GlenSearle/Pogo-pin-clamp/pogo.stl

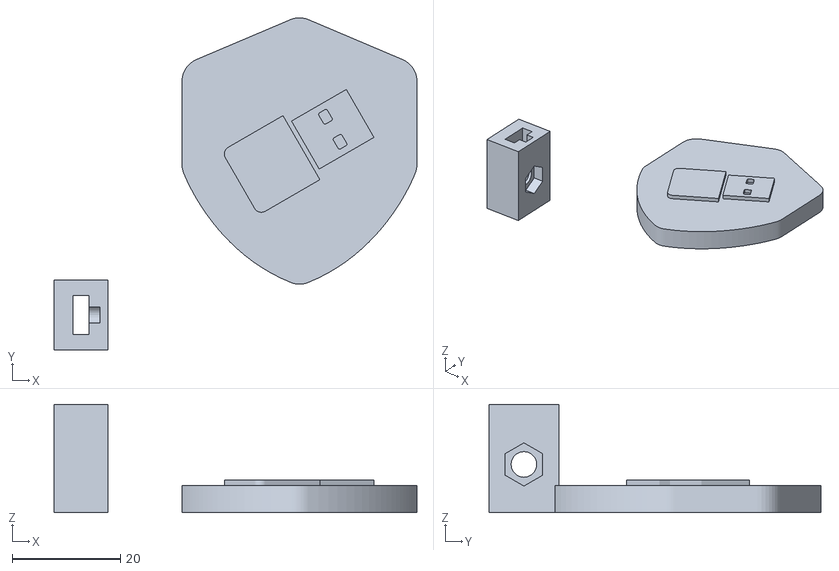
[picture p1: CAD file, 2023-05-11]
pogo.stl
67.2 x 61.5 x 20.0
