GlenSearle/Pogo-pin-clamp/pogo-clamp_chonky-base.stl

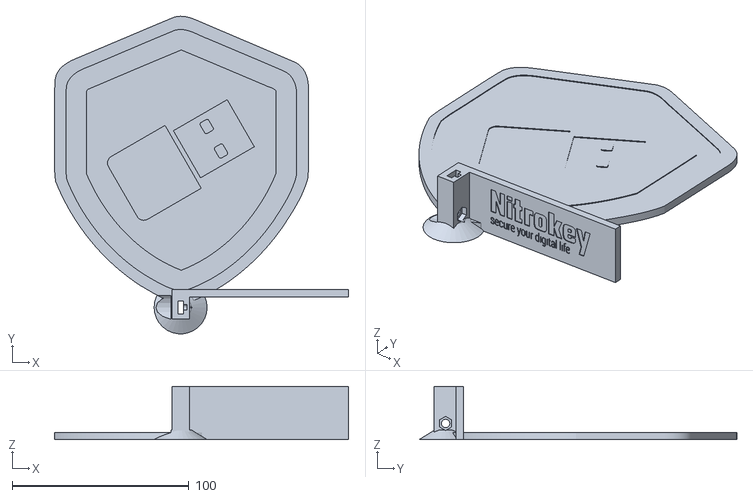
[picture p2: CAD file, 2023-05-11]
pogo-clamp_chonky-base.stl
166.4 x 179.7 x 30.0
