GlenSearle/Pogo-pin-clamp/pogo_base-aligning.stl

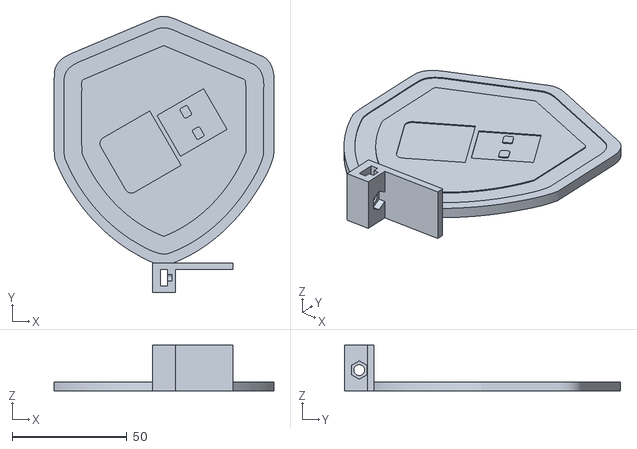
[picture p3: CAD file, 2023-05-11]
pogo_base-aligning.stl
95.8 x 120.3 x 20.0
