GlenSearle/Pogo-pin-clamp/pogo_base_interface.stl

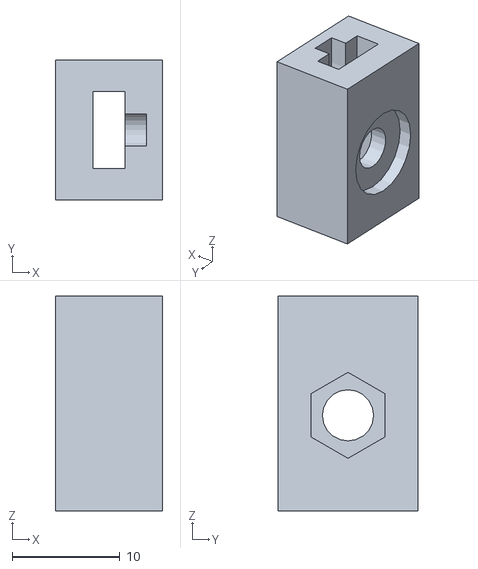
[picture p4: CAD file, 2023-05-11]
pogo_base_interface.stl
10.0 x 13.0 x 20.0
