GlenSearle/Pogo-pin-clamp/Pogo-pad-holder.stl

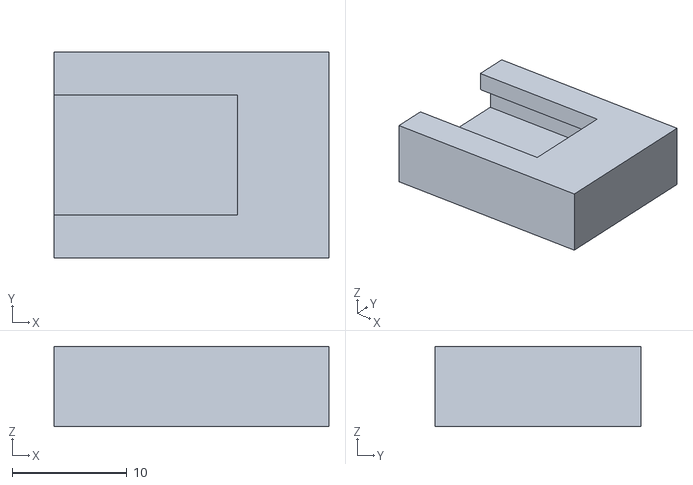
[picture p5: CAD file, 2023-05-11]
Pogo-pad-holder.stl
24.0 x 18.0 x 7.00
