GlenSearle/Pogo-pin-clamp/pogo-thumb-pad.stl

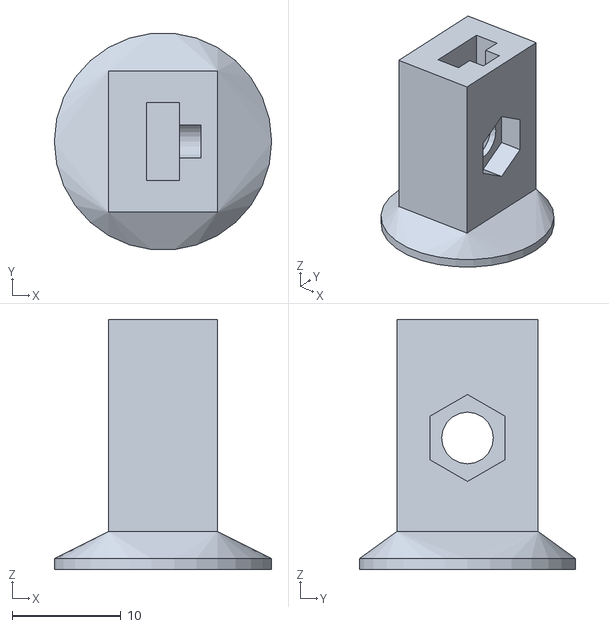
[picture p6: CAD file, 2023-05-11]
pogo-thumb-pad.stl
20.0 x 19.9 x 23.0
