GlenSearle/Pogo-pin-clamp/Pogo-arm.stl

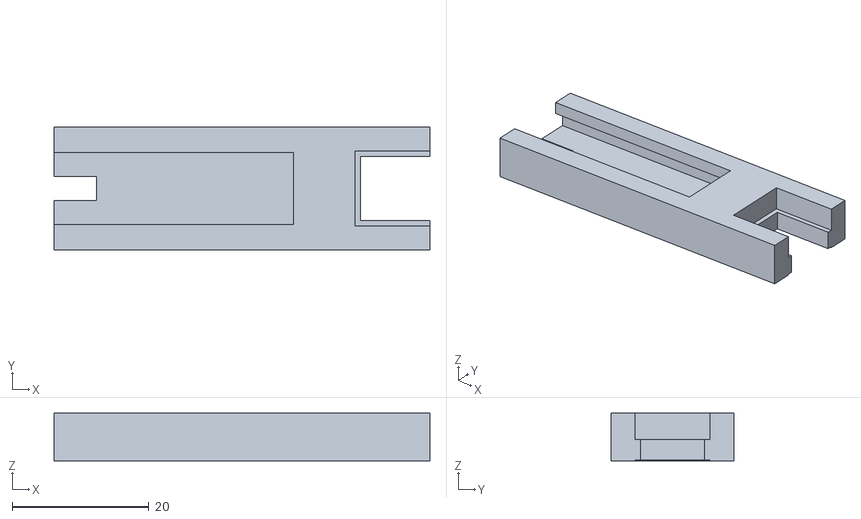
[picture p7: CAD file, 2023-05-11]
Pogo-arm.stl
55.0 x 18.0 x 7.00
