GlenSearle/Pogo-pin-clamp/Pogo-grip.stl

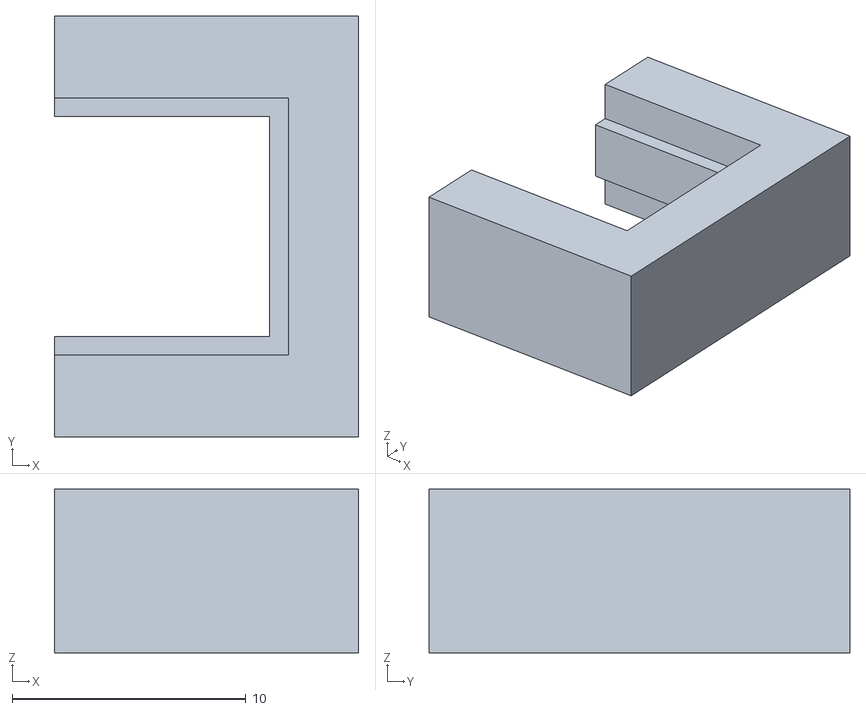
[picture p8: CAD file, 2023-05-11]
Pogo-grip.stl
13.0 x 18.0 x 7.00
