GlenSearle/Pogo-pin-clamp/pogo_base.stl

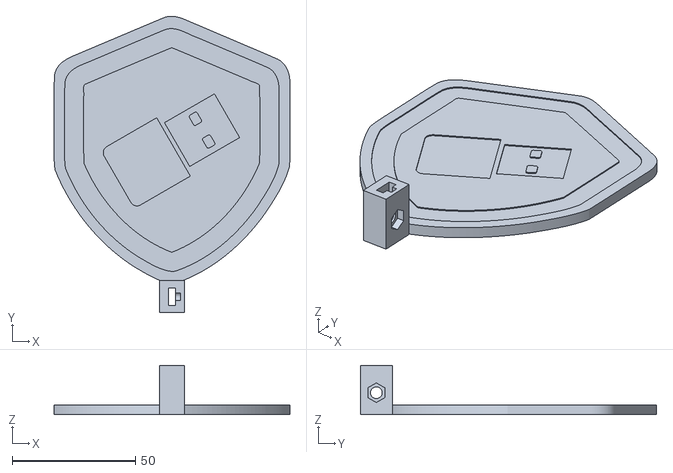
[picture p9: CAD file, 2023-05-11]
pogo_base.stl
95.8 x 120.3 x 20.0
