GlenSearle/Pogo-pin-clamp/(list of files, cad)

Other CAD files:
pogo-thumb-pad.scad
pogo-working_shaft.scad
pogo.scad
pogo_base.scad
pogo_base_light.scad
